Shadowplayers-Spelforening/GameBuzzer/partlist_annotated.jpg

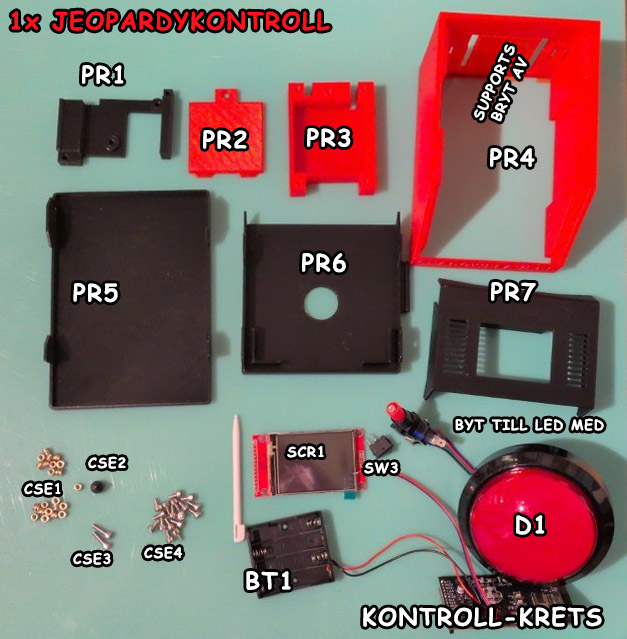
partlist_annotated.jpg
