Shadowplayers-Spelforening/GameBuzzer/v2_pcb.jpg

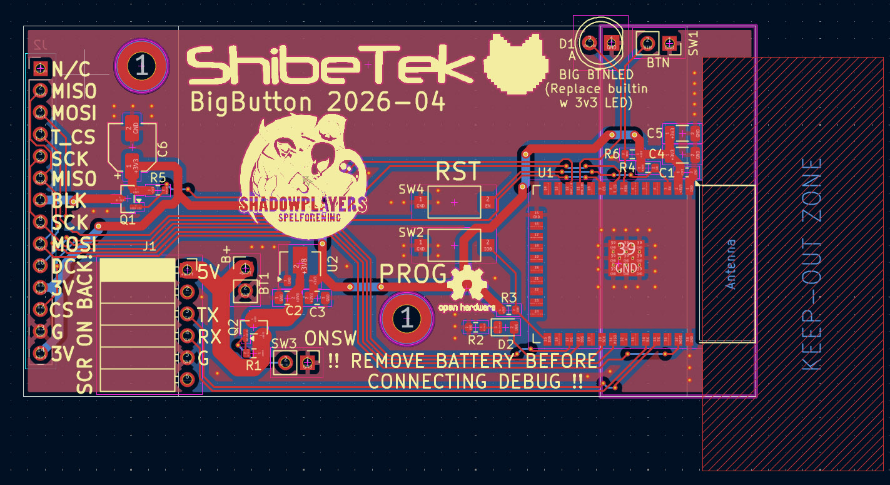
v2_pcb.jpg
