Shadowplayers-Spelforening/GameBuzzer/3d/buzzer_black_02mm.3mf

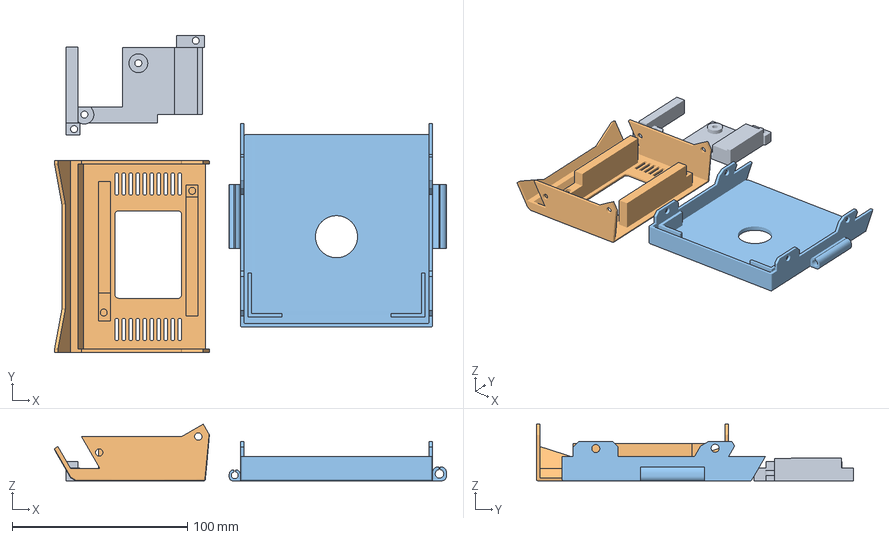
[picture p3: CAD file, 2026-10-18]
3d/buzzer_black_02mm.3mf
223.8 x 181.3 x 32.4 mm
PR1_front_insert.stl
PR7_front.stl
PR6_lid.stl
