Shadowplayers-Spelforening/GameBuzzer/3d/buzzer_color.3mf

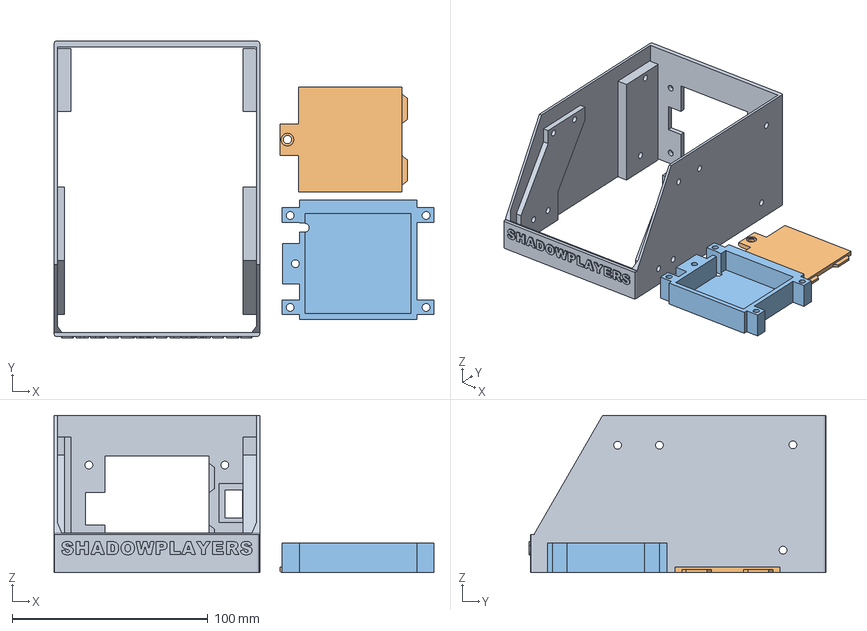
[picture p4: CAD file, 2026-10-18]
3d/buzzer_color.3mf
193.9 x 151.6 x 80.2 mm
buzzer_body.stl
PR2_batteryholder_lid.stl
PR3_batteryholder.stl
