Shadowplayers-Spelforening/GameBuzzer/3d/buzzer_black_03mm.3mf

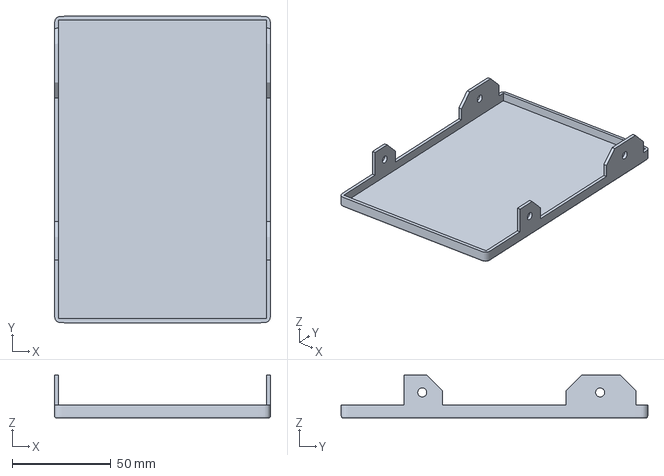
[picture p5: CAD file, 2026-10-18]
3d/buzzer_black_03mm.3mf
109.4 x 155.3 x 21.7 mm
