Shadowplayers-Spelforening/GameBuzzer/3d/PR2_batteryholder_lid.stl

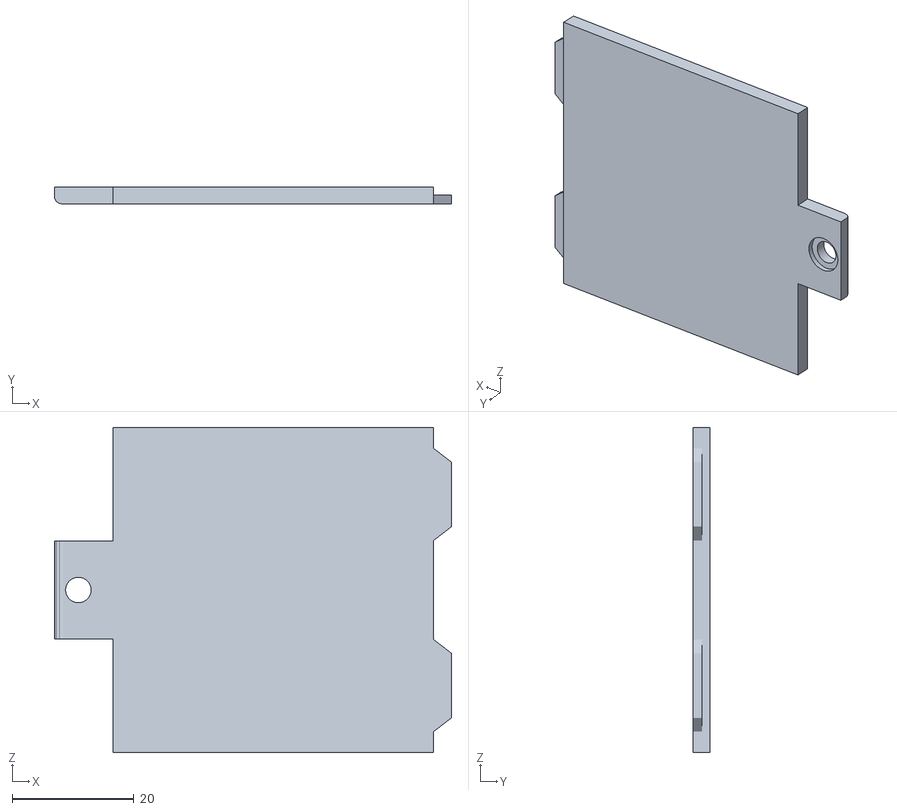
[picture p6: CAD file, 2026-10-16]
3d/PR2_batteryholder_lid.stl
65.3 x 2.81 x 53.5
