Shadowplayers-Spelforening/GameBuzzer/3d/PR4_body.stl

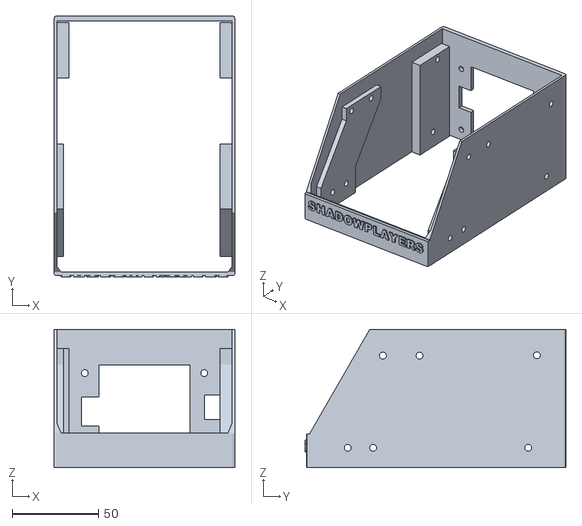
[picture p7: CAD file, 2026-10-16]
3d/PR4_body.stl
105.0 x 151.6 x 80.2
