Shadowplayers-Spelforening/GameBuzzer/3d/PR7_front.stl

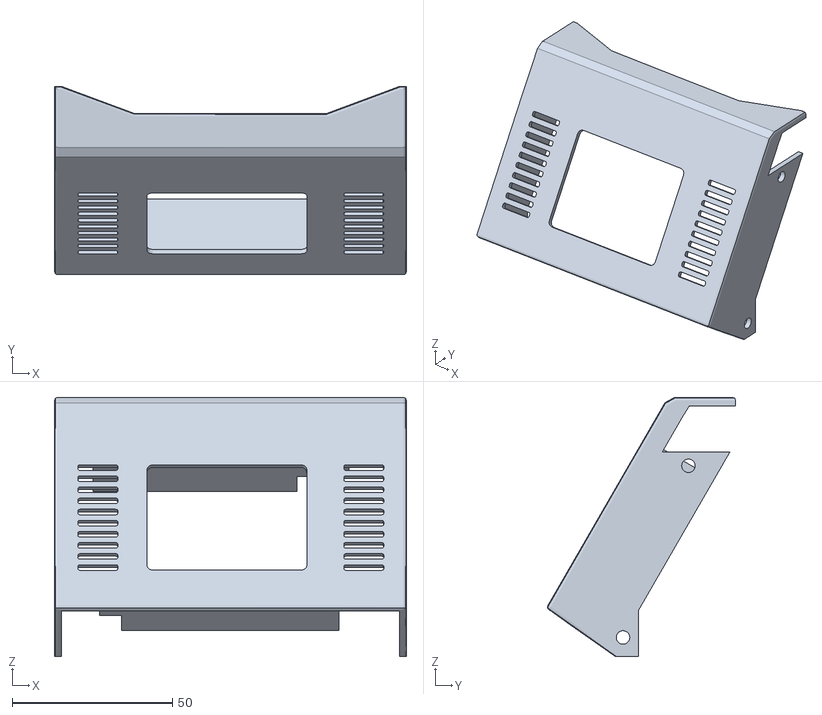
[picture p8: CAD file, 2026-10-16]
3d/PR7_front.stl
109.8 x 58.8 x 80.9
