Shadowplayers-Spelforening/GameBuzzer/3d/HR2_base.stl

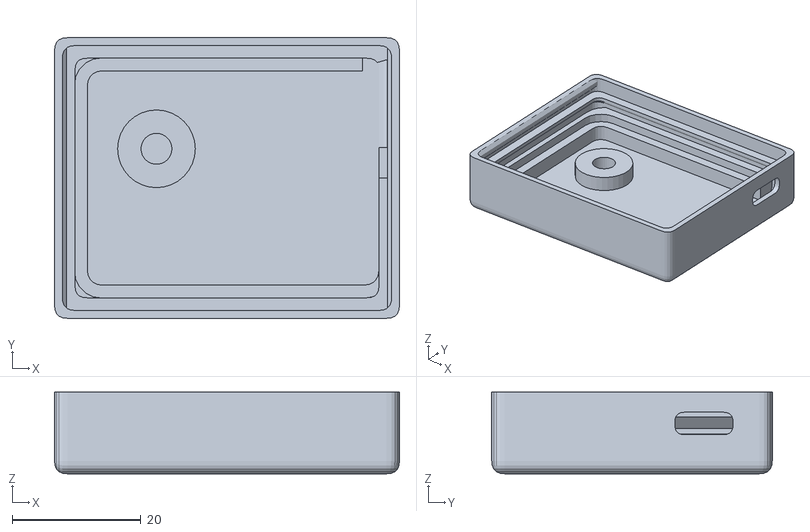
[picture p9: CAD file, 2026-10-16]
3d/HR2_base.stl
53.6 x 43.6 x 12.7
