Shadowplayers-Spelforening/GameBuzzer/3d/PR3_batteryholder.stl

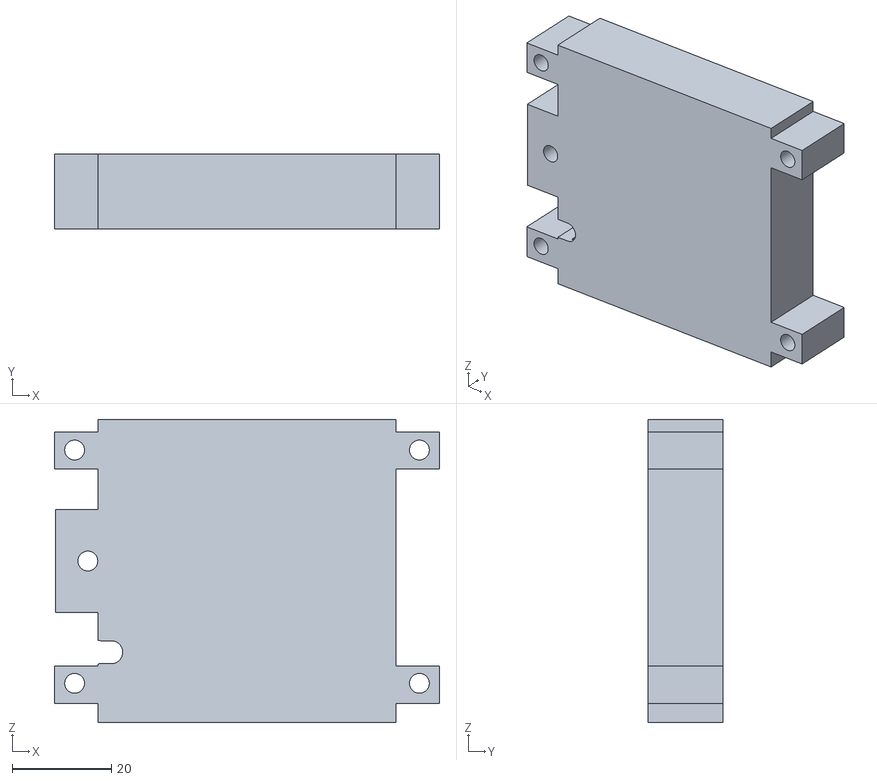
[picture p10: CAD file, 2026-10-16]
3d/PR3_batteryholder.stl
77.5 x 15.2 x 61.1
