Shadowplayers-Spelforening/GameBuzzer/3d/HR1_lid.stl

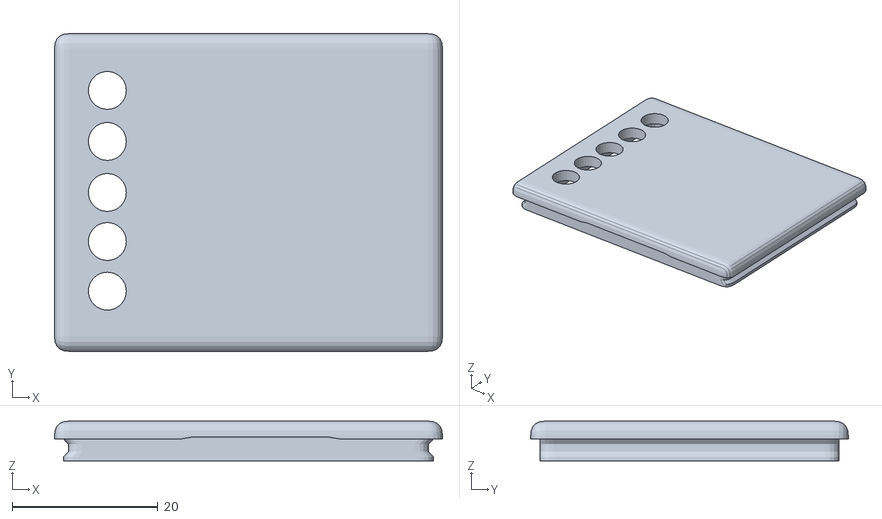
[picture p11: CAD file, 2026-10-16]
3d/HR1_lid.stl
53.2 x 43.6 x 5.46
