Shadowplayers-Spelforening/GameBuzzer/3d/test_buzzer_insert.3mf

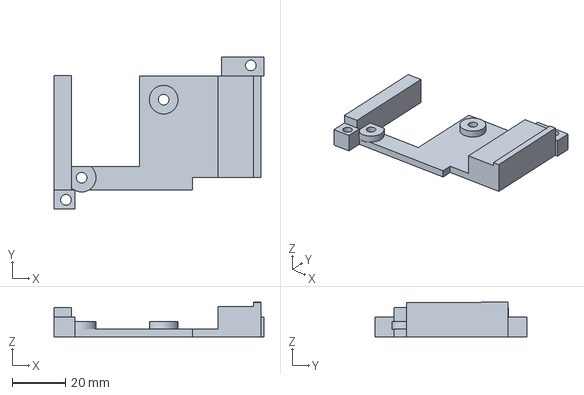
[picture p12: CAD file, 2026-10-16]
3d/test_buzzer_insert.3mf
78.9 x 57.0 x 13.1 mm
