Shadowplayers-Spelforening/GameBuzzer/3d/PR6_lid.stl

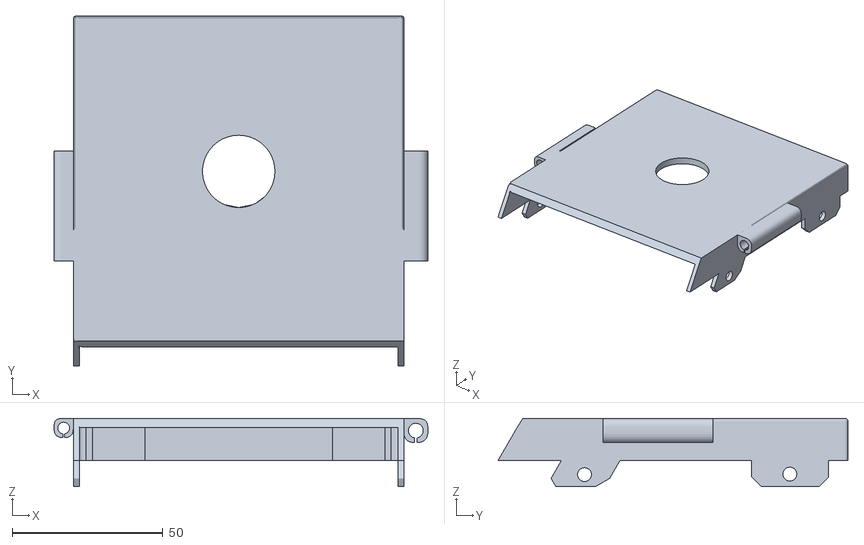
[picture p13: CAD file, 2026-10-16]
3d/PR6_lid.stl
124.1 x 116.2 x 22.6
