Shadowplayers-Spelforening/GameBuzzer/3d/HR1n_text.stl

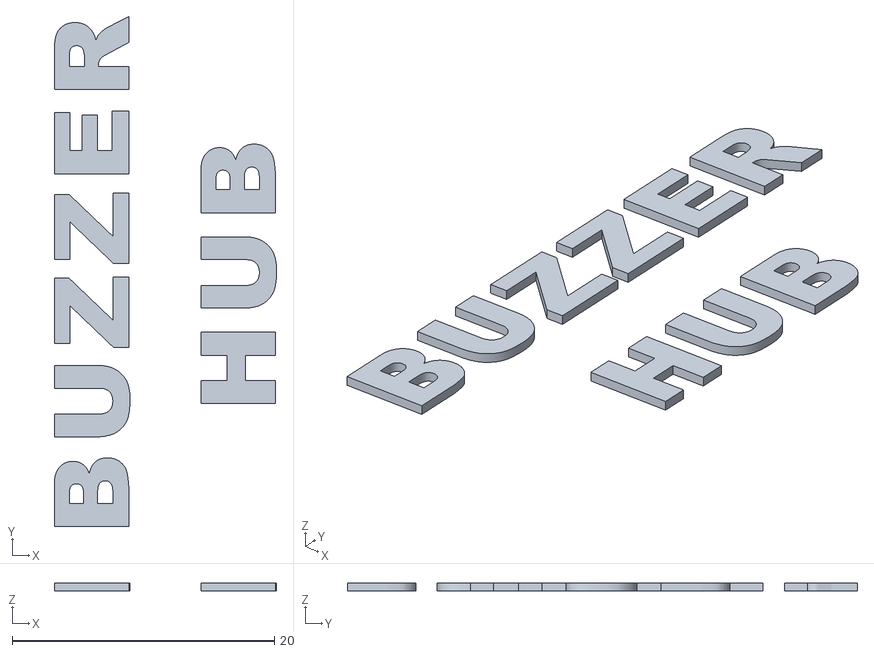
[picture p14: CAD file, 2026-10-16]
3d/HR1n_text.stl
17.0 x 38.9 x 0.6
