Shadowplayers-Spelforening/GameBuzzer/3d/buzzer_hub.3mf

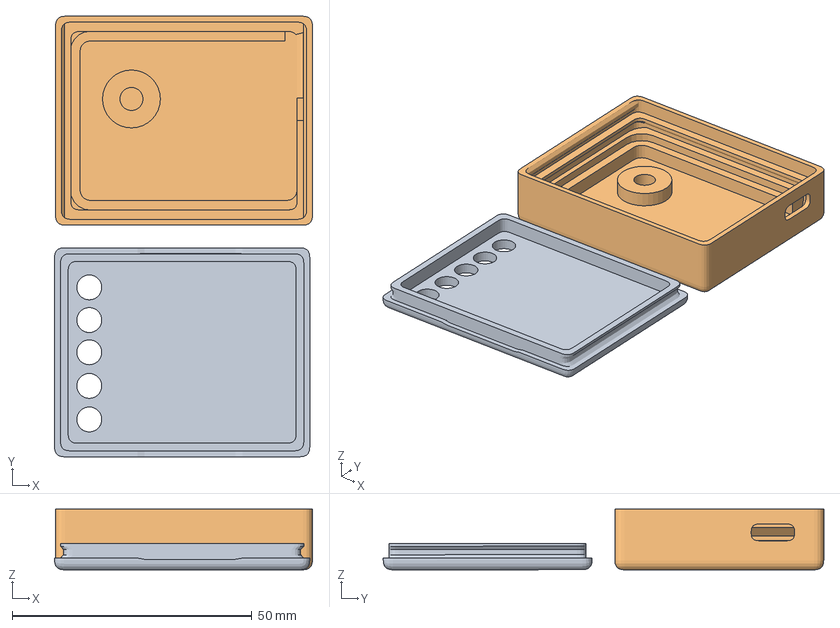
[picture p15: CAD file, 2026-10-16]
3d/buzzer_hub.3mf
53.8 x 91.9 x 12.7 mm
HR1_lid
HR2_base.stl
