Shadowplayers-Spelforening/GameBuzzer/3d/PR1_front_insert.stl

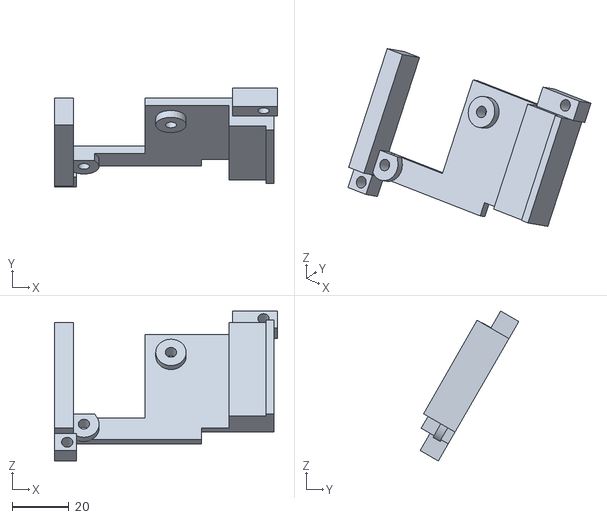
[picture p16: CAD file, 2026-10-16]
3d/PR1_front_insert.stl
78.9 x 34.9 x 53.1
