Shadowplayers-Spelforening/GameBuzzer/(list of files, cad)

Other CAD files:
3d/PR5_bottom.stl
