Shadowplayers-Spelforening/GameBuzzer/ButtonGameController/Controller/Controller.kicad_pcb

## KiCad design ButtonGameController/Controller/Controller.kicad_pcb (2026-10-22)

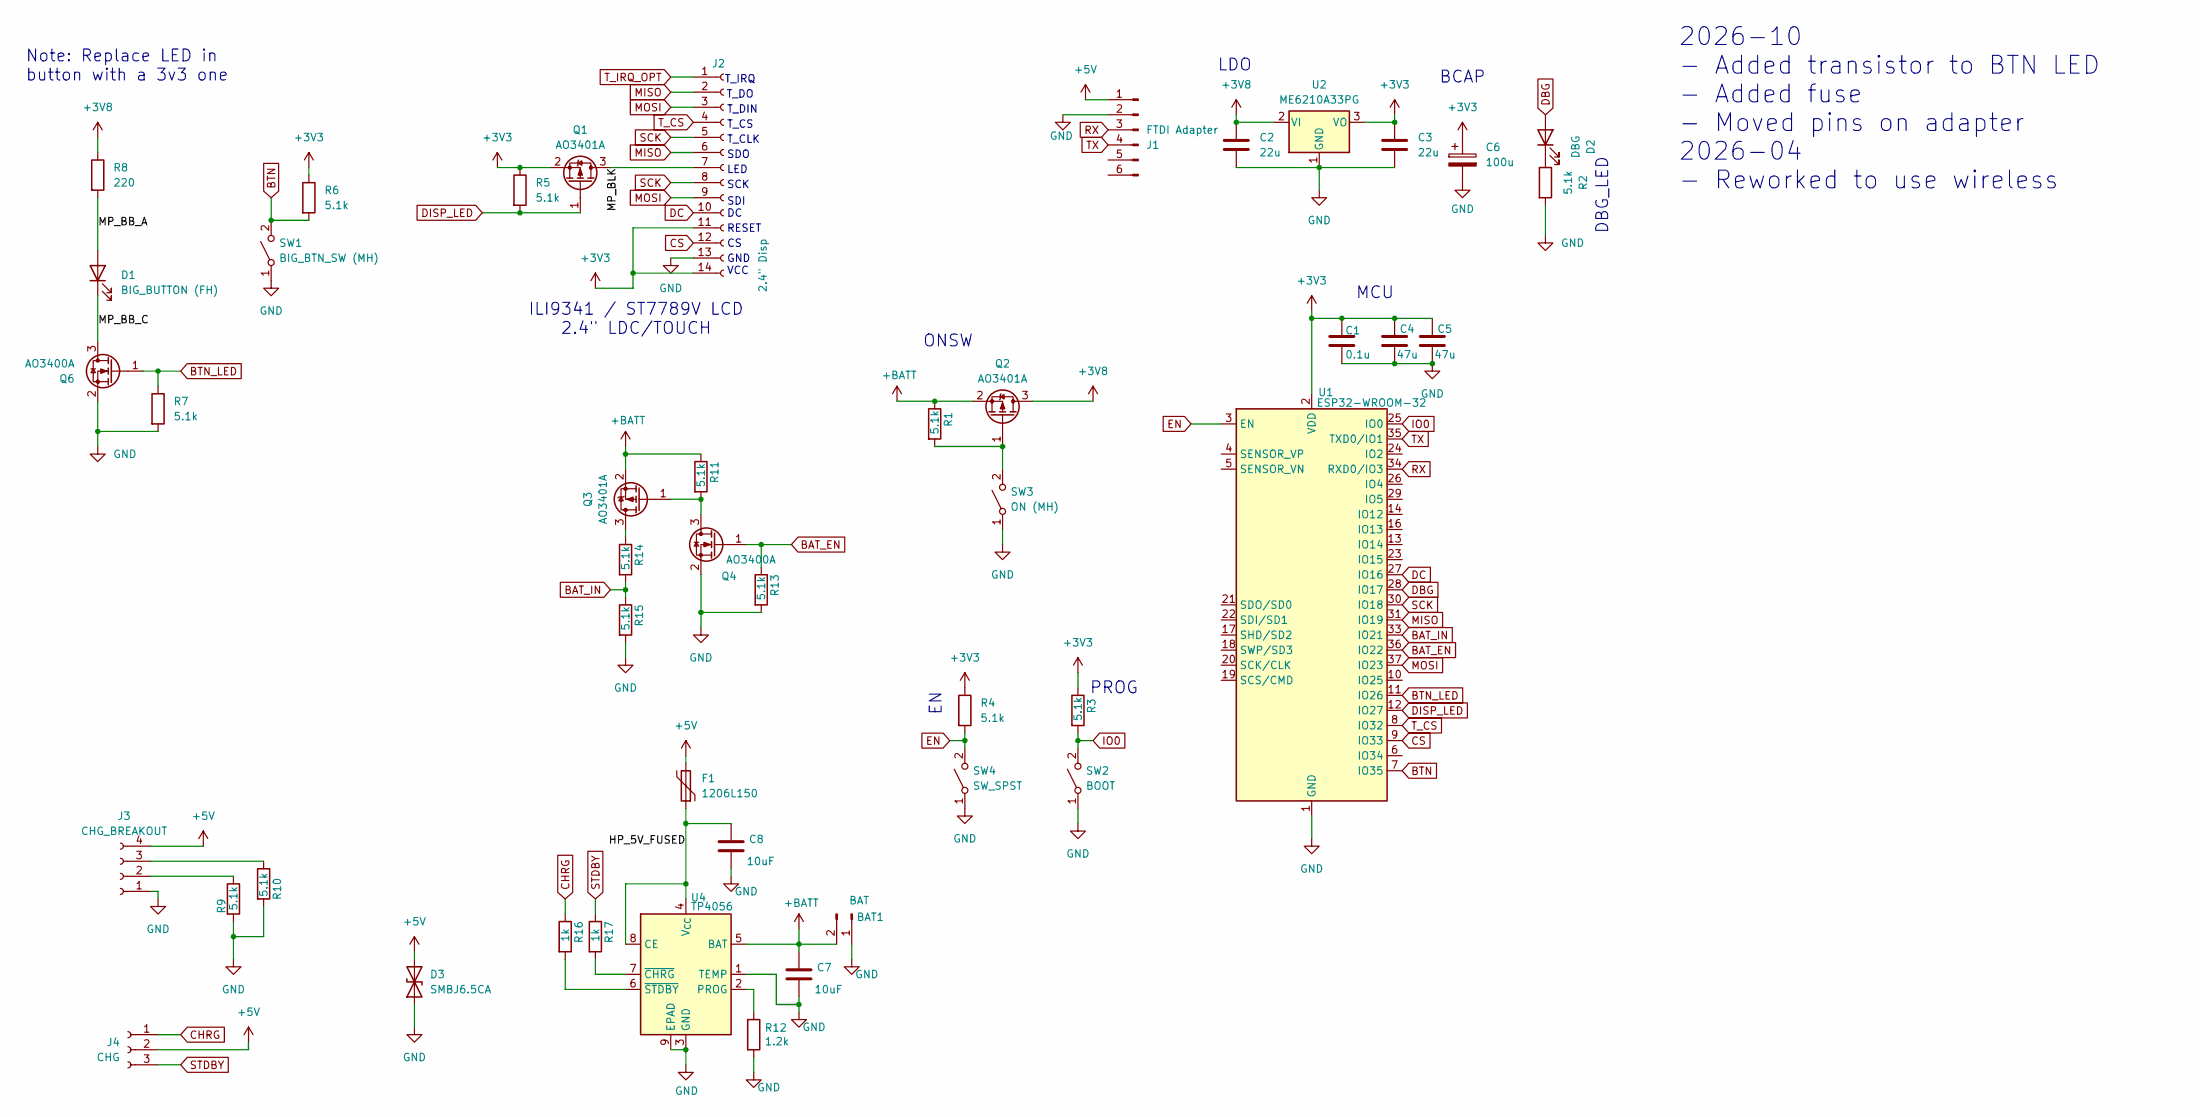
[picture p17: schematic Controller.kicad_sch]

Parts:
BAT1: BAT; PinSocket_1x02_P2.54mm_Vertical
C1: 0.1u; C_0603_1608Metric
C2, C3: 22u; C_0805_2012Metric
C4, C5: 47u; C_1206_3216Metric
C6: 100u; CP_Elec_5x5.4
C7, C8: 10uF; C_0805_2012Metric; LCSC C15850
D1: BIG_BUTTON (FH); LED_D5.0mm
D2: DBG; LED_0805_2012Metric
D3: SMBJ6.5CA; D_SMB_Unidirectional
F1: 1206L150; Fuse_1206_3216Metric
J1: FTDI Adapter; PinSocket_1x06_P2.54mm_Horizontal
J2: 2.4" Disp; PinSocket_1x14_P2.54mm_Vertical
J3: CHG_BREAKOUT; JST_PH_B4B-PH-K_1x04_P2.00mm_Vertical
J4: CHG; PinSocket_1x03_P2.54mm_Vertical
Q1, Q2, Q3: AO3401A; SOT-23
Q4, Q6: AO3400A; SOT-23
R1, R2, R3, R4, R5, R6, R7, R9, R10, R11, R13, R14, R15: 5.1k; R_0603_1608Metric
R8: 220; R_0805_2012Metric
R12: 1.2k; R_0603_1608Metric; LCSC C4177
R16, R17: 1k; R_0603_1608Metric
SW1: BIG_BTN_SW (MH); PinSocket_1x02_P2.54mm_Vertical
SW2: BOOT; SW_SPST_CK_RS282G05A3
SW3: ON (MH); PinHeader_1x02_P2.54mm_Vertical
SW4: SW_SPST; SW_SPST_CK_RS282G05A3
U1: ESP32-WROOM-32
U2: ME6210A33PG; SOT-89-3
U4: TP4056; SOIC-8-1EP_3.9x4.9mm_P1.27mm_EP2.41x3.3mm_ThermalVias; LCSC C725790

Connections:
+3V3: C1.1, C3.2, C4.1, C5.1, C6.1, J2.11, J2.14, Q1.2 (S), R3.1, R4.1, R5.1, R6.1, U1.2 (VDD), U2.3 (VO)
+3V8: C2.2, Q2.3 (D), R8.1, U2.2 (VI)
+5V: D3.2 (A2), F1.2, J1.1, J3.4, J4.2
+BATT: BAT1.2, C7.1, Q2.2 (S), Q3.2 (S), R1.1, R11.1, U4.5 (BAT)
/HP_5V_FUSED: C8.1, F1.1, U4.4 (V_{CC}), U4.8 (CE)
/MP_BB_A: D1.2 (A), R8.2
/MP_BB_C: D1.1 (K), Q6.3 (D)
/MP_BLK: J2.7, Q1.3 (D)
BAT_EN: Q4.1 (G), R13.1, U1.36 (IO22)
BAT_IN: R14.2, R15.1, U1.33 (IO21)
BTN: R6.2, SW1.2 (B), U1.7 (IO35)
BTN_LED: Q6.1 (G), R7.1, U1.11 (IO26)
CHRG: J4.1, R16.1
CS: J2.12, U1.9 (IO33)
DBG: D2.2 (A), U1.28 (IO17)
DC: J2.10, U1.27 (IO16)
DISP_LED: Q1.1 (G), R5.2, U1.12 (IO27)
EN: R4.2, SW4.2 (B), U1.3 (EN)
GND: BAT1.1, C1.2, C2.1, C3.1, C4.2, C5.2, C6.2, C7.2, C8.2, D3.1 (A1), J1.2, J2.13, J3.1, Q4.2 (S), Q6.2 (S), R2.2, R7.2, R9.2, R10.2, R12.2, R13.2, R15.2, SW1.1 (A), SW2.1 (A), SW3.1 (A), SW4.1 (A), U1.1 (GND), U1.15 (GND), U1.38 (GND), U1.39 (GND), U2.1 (GND), U4.1 (TEMP), U4.3 (GND), U4.9 (EPAD)
IO0: R3.2, SW2.2 (B), U1.25 (IO0)
MISO: J2.2, J2.6, U1.31 (IO19)
MOSI: J2.3, J2.9, U1.37 (IO23)
unnamed: D2.1 (K), R2.1
unnamed: J3.2, R9.1
unnamed: J3.3, R10.1
unnamed: Q2.1 (G), R1.2, SW3.2 (B)
unnamed: Q3.3 (D), R14.1
unnamed: Q3.1 (G), Q4.3 (D), R11.2
unnamed: R12.1, U4.2 (PROG)
unnamed: R17.2, U4.7 (~CHRG)
unnamed: R16.2, U4.6 (~STDBY)
RX: J1.3, U1.34 (RXD0/IO3)
SCK: J2.5, J2.8, U1.30 (IO18)
STDBY: J4.3, R17.1
TX: J1.4, U1.35 (TXD0/IO1)
T_CS: J2.4, U1.8 (IO32)
T_IRQ_OPT: J2.1

Notes on the sheet:
T_CS
PROG
VCC
LED
DBG_LED
GND
T_IRQ
MCU
ILI9341 / ST7789V LCD 2.4" LDC/TOUCH
T_CLK
LDO
Note: Replace LED in button with a 3v3 one
ONSW
T_DIN
BCAP
RESET
T_DO
SCK
SDI
2026-10 - Added transistor to BTN LED - Added fuse - Moved pins on adapter 2026-04 - Reworked to use wireless
SDO

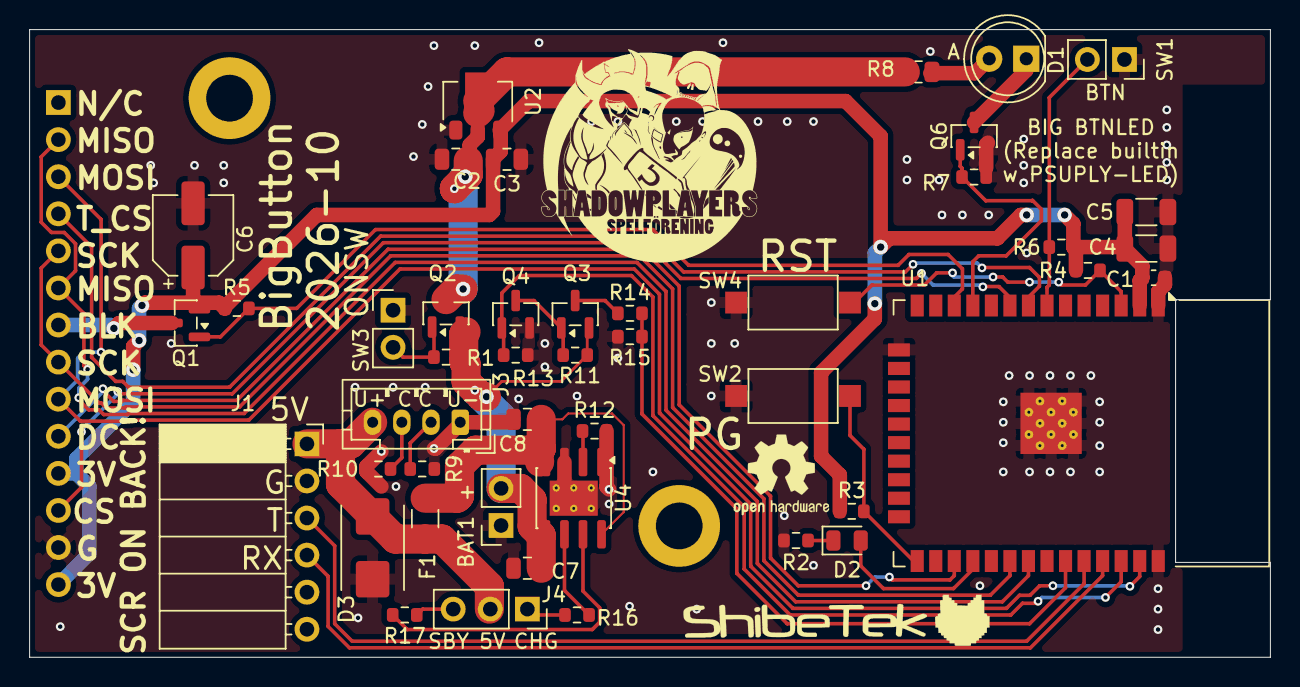
[picture p18: board Controller.kicad_pcb from above]

Board: 2 copper layers, 85.0 x 43.0 mm, 46 parts (1 on the bottom side), 36 nets.
