Shadowplayers-Spelforening/GameBuzzer/ButtonGameController/ButtonGameController.kicad_pcb

## KiCad design ButtonGameController/ButtonGameController.kicad_pcb (2026-10-16)

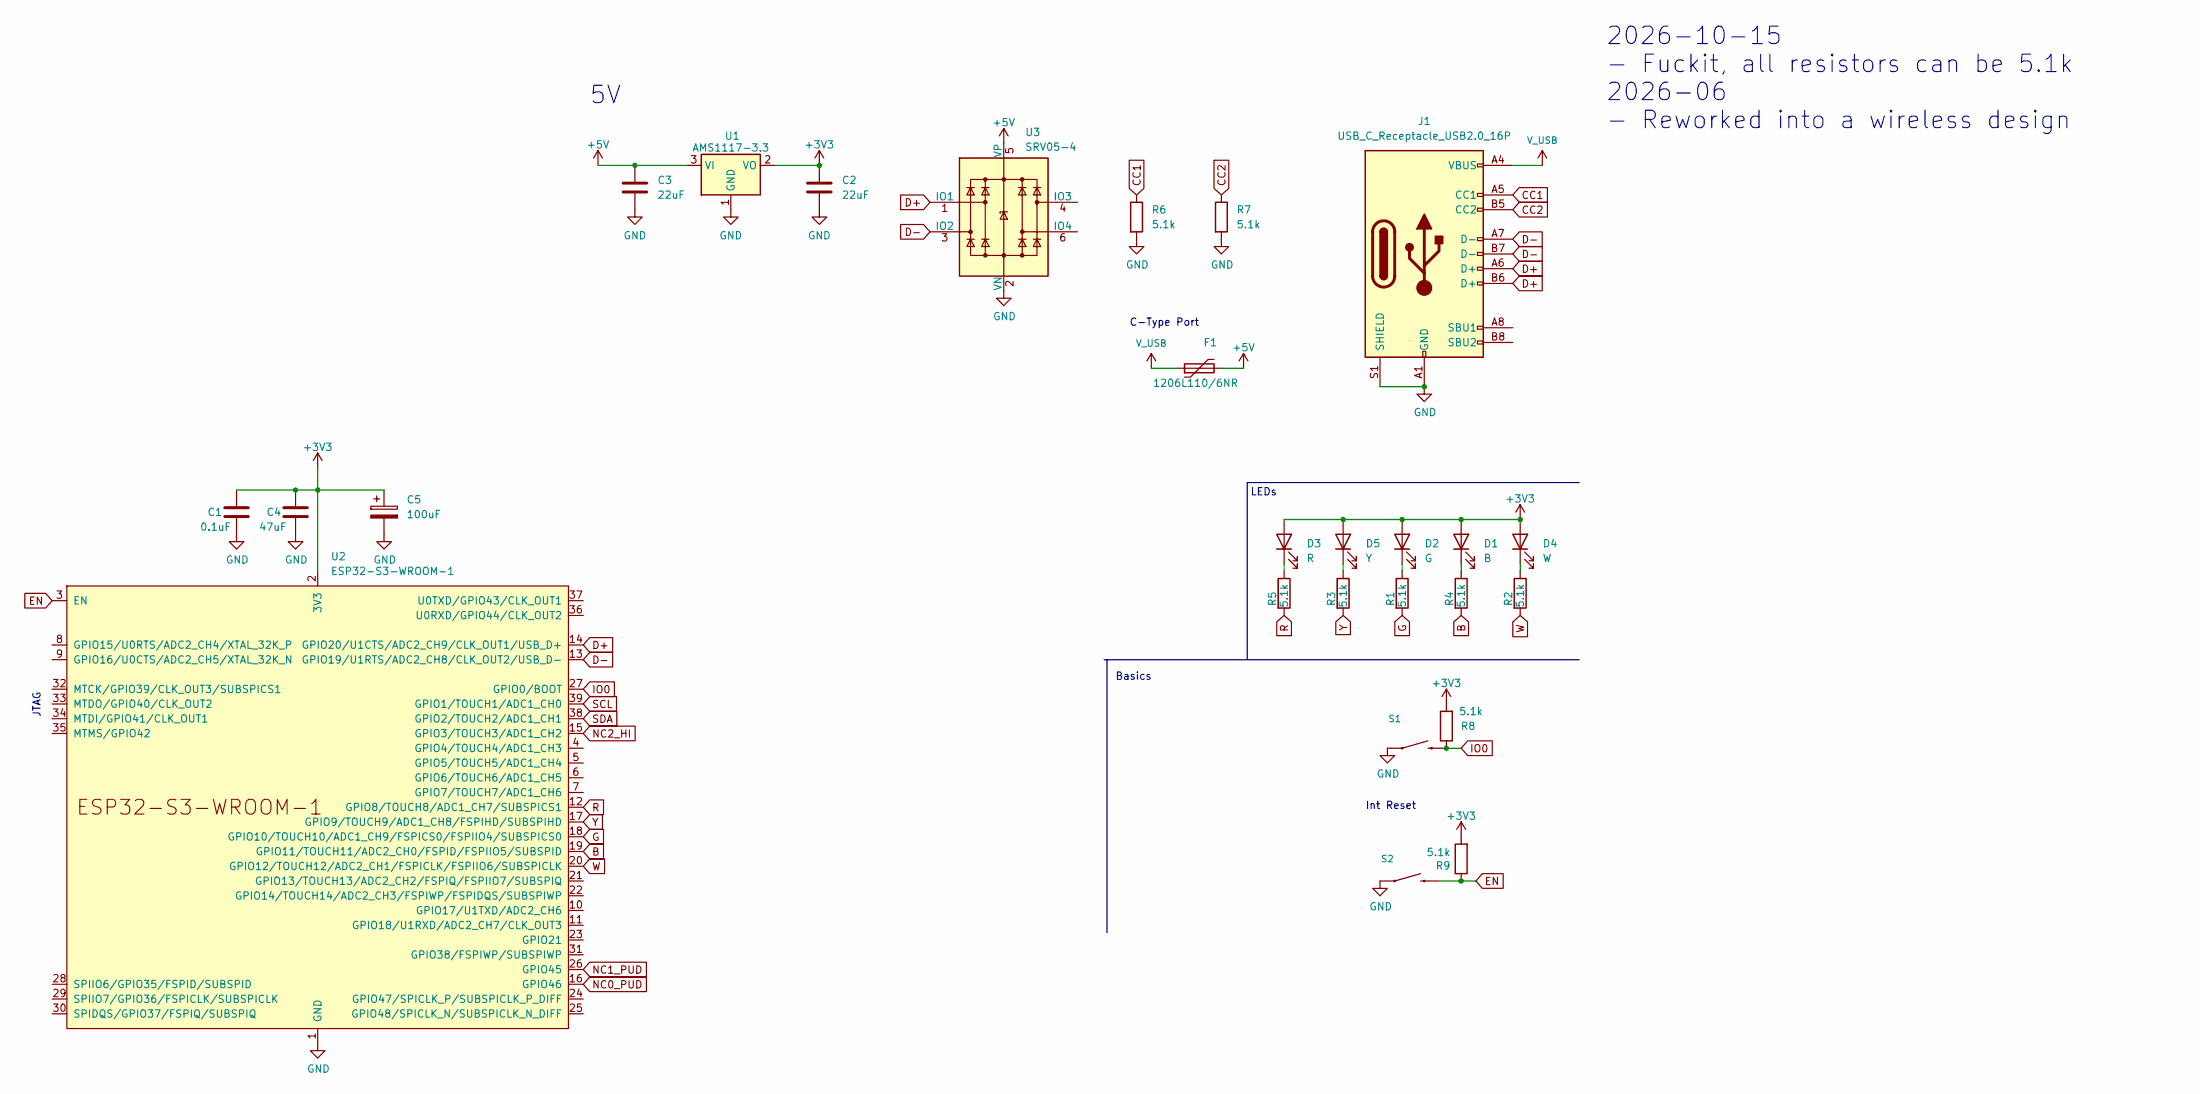
[picture p19: schematic ButtonGameController.kicad_sch]

Parts:
C1: 0.1uF; C_0603_1608Metric
C2, C3: 22uF; C_0805_2012Metric
C4: 47uF; C_1206_3216Metric
C5: 100uF; CP_Elec_5x4.5
D1: B; LED_D5.0mm
D2: G; LED_D5.0mm
D3: R; LED_D5.0mm
D4: W; LED_D5.0mm
D5: Y; LED_D5.0mm
F1: 1206L110/6NR; Fuse_1206_3216Metric
J1: USB_C_Receptacle_USB2.0_16P; USB_C_Receptacle_GCT_USB4105-xx-A_16P_TopMnt_Horizontal
R1, R2, R3, R4, R5, R6, R7, R8, R9: 5.1k; R_0603_1608Metric
S1: BOOT; SW_Tactile_SPST_NO_Straight_CK_PTS636Sx25SMTRLFS
S2: RST; SW_Tactile_SPST_NO_Straight_CK_PTS636Sx25SMTRLFS
U1: AMS1117-3.3; SOT-223-3_TabPin2
U2: ESP32-S3-WROOM-1
U3: SRV05-4; SOT-23-6

Connections:
+3V3: C1.1, C2.1, C4.1, C5.1, D1.2 (A), D2.2 (A), D3.2 (A), D4.2 (A), D5.2 (A), R8.2, R9.2, U1.2 (VO), U2.2 (3V3)
+5V: C3.1, F1.2, U1.3 (VI), U3.5 (VP)
B: R4.2, U2.19 (GPIO11/TOUCH11/ADC2_CH0/FSPID/FSPIIO5/S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)
CC1: J1.A5 (CC1), R6.1
CC2: J1.B5 (CC2), R7.1
D+: J1.A6 (D+), J1.B6 (D+), U2.14 (GPIO20/U1CTS/ADC2_CH9/CLK_OUT1/USB_D+), U3.1 (IO1)
D-: J1.A7 (D-), J1.B7 (D-), U2.13 (GPIO19/U1RTS/ADC2_CH8/CLK_OUT2/USB_D-), U3.3 (IO2)
EN: R9.1, S2.2, U2.3 (EN)
G: R1.2, U2.18 (GPIO10/TOUCH10/ADC1_CH9/FSPICS0/FSPIIO4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)
GND: C1.2, C2.2, C3.2, C4.2, C5.2, J1.A1 (GND), J1.A12 (GND), J1.B1 (GND), J1.B12 (GND), J1.S1 (SHIELD), R6.2, R7.2, S1.1, S2.1, U1.1 (GND), U2.1 (GND), U2.40 (GND), U2.41 (GND), U3.2 (VN)
IO0: R8.1, S1.2, U2.27 (GPIO0/BOOT)
NC0_PUD: U2.16 (GPIO46)
NC1_PUD: U2.26 (GPIO45)
NC2_HI: U2.15 (GPIO3/TOUCH3/ADC1_CH2)
unnamed: D1.1 (K), R4.1
unnamed: D2.1 (K), R1.1
unnamed: D3.1 (K), R5.1
unnamed: D4.1 (K), R2.1
unnamed: D5.1 (K), R3.1
R: R5.2, U2.12 (GPIO8/TOUCH8/ADC1_CH7/SUBSPICS1)
SCL: U2.39 (GPIO1/TOUCH1/ADC1_CH0)
SDA: U2.38 (GPIO2/TOUCH2/ADC1_CH1)
V_USB: F1.1, J1.A4 (VBUS), J1.A9 (VBUS), J1.B4 (VBUS), J1.B9 (VBUS)
W: R2.2, U2.20 (GPIO12/TOUCH12/ADC2_CH1/FSPICLK/FSPIIO6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)
Y: R3.2, U2.17 (GPIO9/TOUCH9/ADC1_CH8/FSPIHD/SUBSPIHD)

Notes on the sheet:
LEDs
C-Type Port
2026-10-15 - Fuckit, all resistors can be 5.1k 2026-06 - Reworked into a wireless design
Int Reset
JTAG
Basics

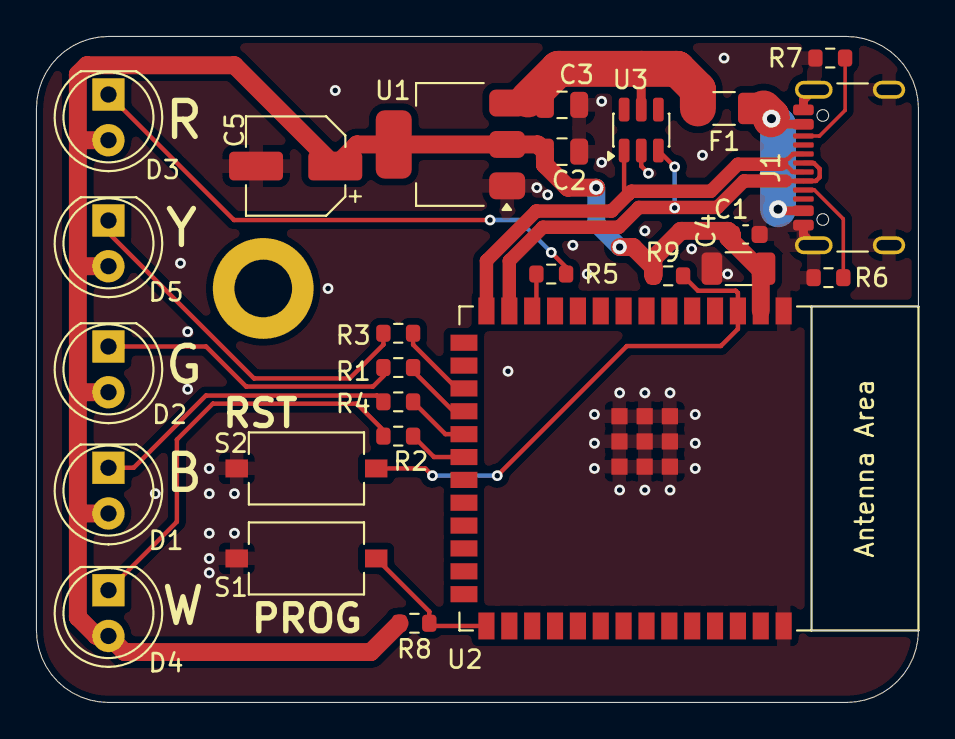
[picture p20: board ButtonGameController.kicad_pcb from above]

Board: 2 copper layers, 49.0 x 37.0 mm, 26 parts (0 on the bottom side), 20 nets.
