Shadowplayers-Spelforening/GameBuzzer/Code/GameBuzzer-Hub/_Configuration.h

#pragma once
#include <arduino.h>

namespace Configuration{

	const uint8_t PIN_LED_R = 8;
	const uint8_t PIN_LED_Y = 9;
	const uint8_t PIN_LED_G = 10;
	const uint8_t PIN_LED_B = 11;
	const uint8_t PIN_LED_W = 12;



}
