Shadowplayers-Spelforening/GameBuzzer/(commit log)

2026-10-16 IT BEGINS!
    [BOM.ods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]
2026-10-16 3d fixes
    [PR2_batteryholder_lid.stl, PR4_body.stl, PR7_front.stl, buzzer_black.3mf, buzzer_color.3mf]
2026-10-18 screen config
    [Controller.kicad_pcb, Controller.kicad_sch, buzzer_black.3mf, buzzer_black_02mm.3mf, buzzer_black_03mm.3mf, buzzer_color.3mf]
2026-10-22 display calibration
    [Controller.kicad_pcb, Controller.kicad_sch]
